mueschel/damp/classdamp.brd

## EAGLE design classdamp.brd (2013-05-06)

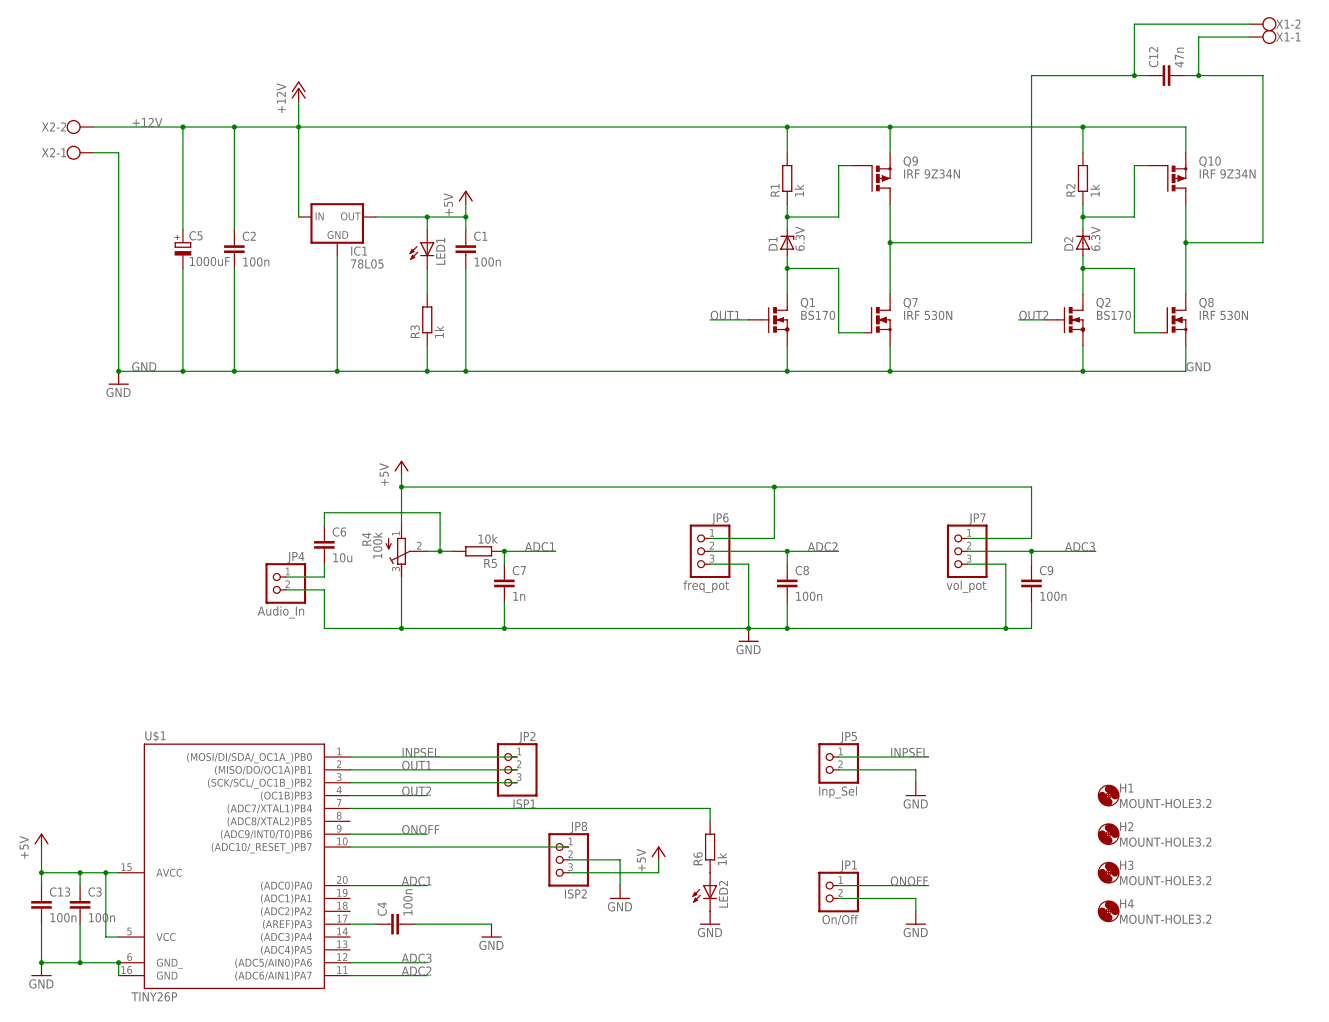
[picture p1: schematic classdamp.sch]

Parts:
C1, C2, C3, C4, C8, C9, C13: 100n; C0805K
C5: 1000uF; E5-8,5
C6: 10u; C0805K
C7: 1n; C0805K
C12: 47n; C5B3.5
D1, D2: 6.3V; ZDIO-5
H1, H2, H3, H4: MOUNT-HOLE3.2; 3,2
IC1: 78L05; 78LXX
JP1: On/Off; 1X02
JP2: ISP1; 1X03
JP4: Audio_In; 1X02
JP5: Inp_Sel; 1X02
JP6: freq_pot; 1X03
JP7: vol_pot; 1X03
JP8: ISP2; 1X03
LED1, LED2: LEDSML0805; SML0805
Q1, Q2: BS170; SOT54E
Q7, Q8: IRF 530N; TO220BV
Q9, Q10: IRF 9Z34N; TO220BV
R1, R2, R3, R6: 1k; R0805
R4: 100k; RTRIM64W
R5: 10k; R0805
U$1: TINY26P; DIL20
X1, X2: W237-102

Connections:
+5V: C1.1, C3.1, C13.1, IC1.OUT, JP6.1, JP7.1, JP8.3, LED1.A, R4.1 (E), U$1.5 (VCC), U$1.15 (AVCC)
+12V: C2.1, C5.+, IC1.IN, Q9.S, Q10.S, R1.2, R2.2, X2.2
ADC1: C7.1, R5.1, U$1.20 ((ADC0)PA0)
ADC2: C8.1, JP6.2, U$1.11 ((ADC6/AIN1)PA7)
ADC3: C9.1, JP7.2, U$1.12 ((ADC5/AIN0)PA6)
GND: C1.2, C2.2, C3.2, C4.2, C5.-, C7.2, C8.2, C9.2, C13.2, IC1.GND, JP1.2, JP4.2, JP5.2, JP6.3, JP7.3, JP8.2, LED2.C, Q1.S, Q2.S, Q7.S, Q8.S, R3.1, R4.3 (A), U$1.6 (GND_), U$1.16 (GND), X2.1
INPSEL: JP2.1, JP5.1, U$1.1 ((MOSI/DI/SDA/_OC1A_)PB0)
unnamed: LED1.C, R3.2
unnamed: C4.1, U$1.17 ((AREF)PA3)
unnamed: LED2.A, R6.1
unnamed: D1.A, Q1.D, Q7.G
unnamed: D2.A, Q2.D, Q8.G
unnamed: D1.C, Q9.G, R1.1
unnamed: D2.C, Q10.G, R2.1
unnamed: C6.2, JP4.1
unnamed: JP2.3, U$1.3 ((SCK/SCL/_OC1B_)PB2)
unnamed: C6.1, R4.2 (S), R5.2
unnamed: C12.1, Q7.D, Q9.D, X1.2
unnamed: JP8.1, U$1.10 ((ADC10/_RESET_)PB7)
unnamed: C12.2, Q8.D, Q10.D, X1.1
unnamed: R6.2, U$1.7 ((ADC7/XTAL1)PB4)
ONOFF: JP1.1, U$1.9 ((ADC9/INT0/T0)PB6)
OUT1: JP2.2, Q1.G, U$1.2 ((MISO/DO/OC1A)PB1)
OUT2: Q2.G, U$1.4 ((OC1B)PB3)

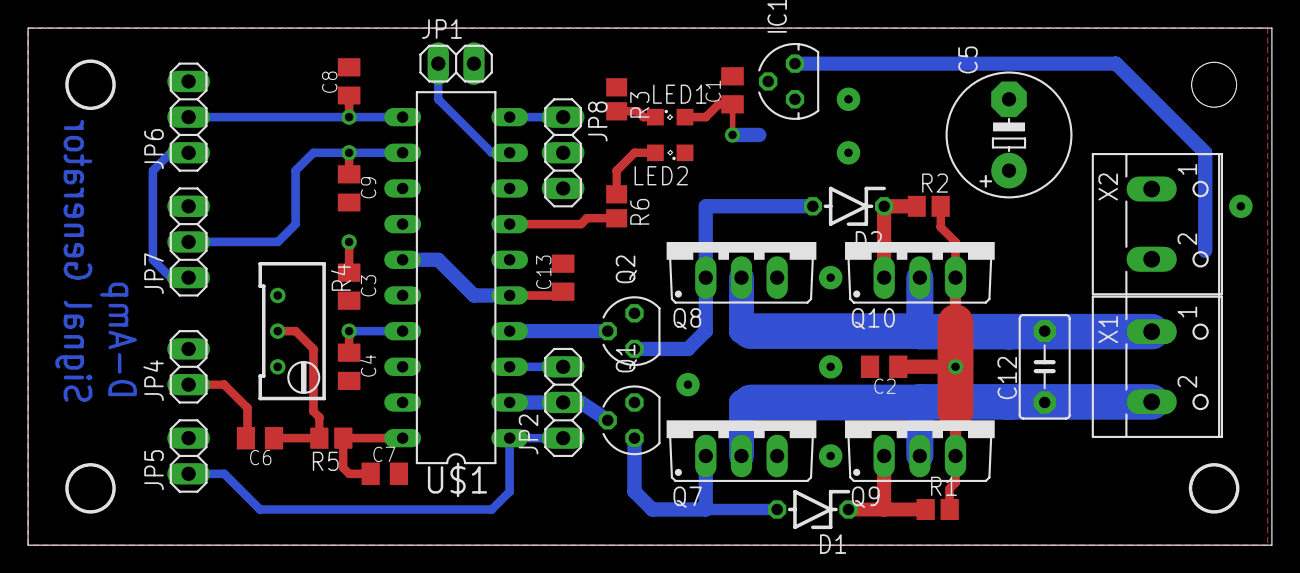
[picture p2: board classdamp.brd from above]

Board: 2 copper layers, 88.6 x 36.8 mm, 42 parts (1 on the bottom side), 24 nets.
