mueschel/damp/damp_orig.brd

## EAGLE design damp_orig.brd (2013-04-27)

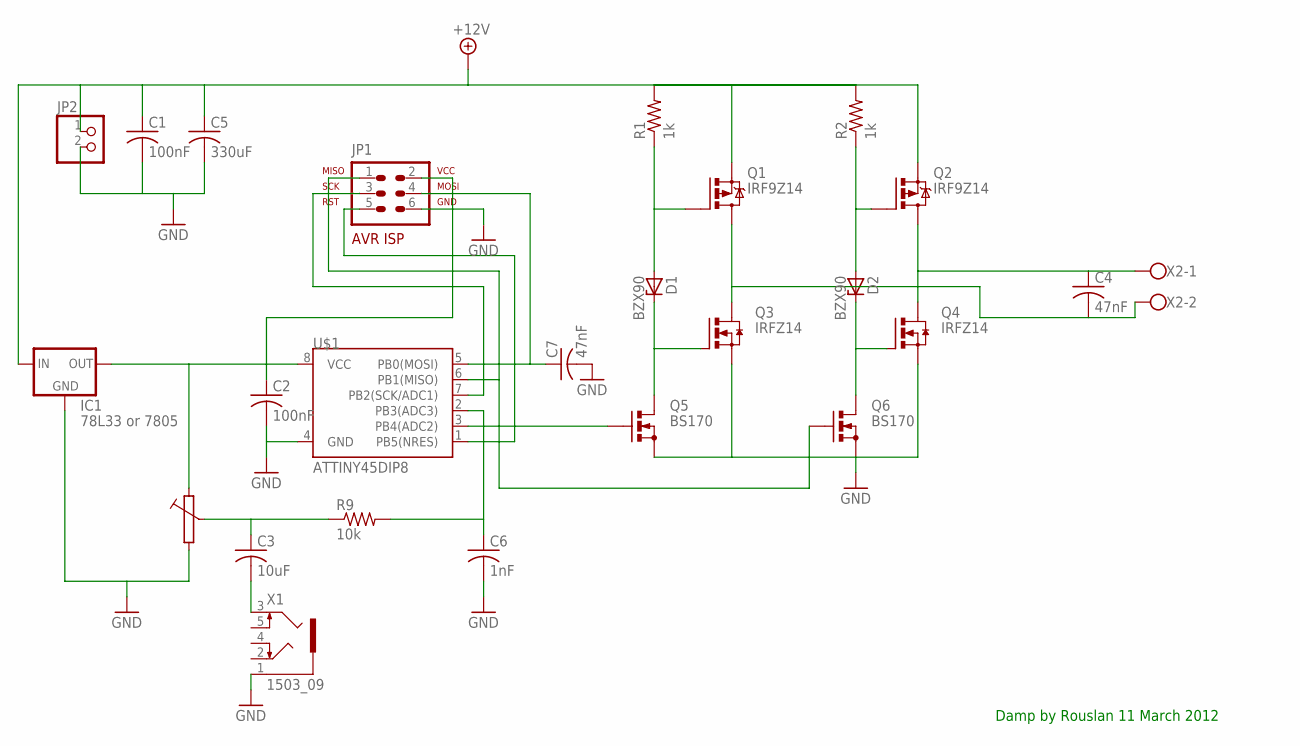
[picture p3: schematic damp_orig.sch]

Parts:
C1, C2: 100nF; C025-025X050
C3: 10uF; C025-025X050
C4, C7: 47nF; C025-025X050
C5: 330uF; C025-025X050
C6: 1nF; C025-025X050
D1, D2: BZX90; DO34Z7
IC1: 78L33 or 7805; TO-92
JP1: AVR-ISP-6VERT; AVR-ISP-6
JP2: PINHD-1X2; 1X02
Q1, Q2: IRF9Z14; TO220BV
Q3, Q4: IRFZ14; TO262-V
Q5, Q6: BS170; SOT54E
R1, R2: 1k; 0204/7
R9: 10k; 0309/10
U$1: ATTINY45DIP8; DIP08
X1: 1503_09
X2: W237-102

Connections:
+12V: C1.1, C5.1, IC1.2 (IN), JP2.1, Q1.S, Q2.S, R1.2, R2.2
GND: C1.2, C2.2, C5.2, C6.2, C7.2, IC1.1 (GND), JP1.6, JP2.2, Q3.3 (S), Q4.3 (S), Q5.S, Q6.S, U$1.4 (GND), X1.1
unnamed: D1.A, Q1.G, R1.1
unnamed: D2.A, Q2.G, R2.1
unnamed: C4.2, Q1.D, Q3.2 (D), X2.2
unnamed: JP1.5, U$1.1 (PB5(NRES))
unnamed: C4.1, Q2.D, Q4.2 (D), X2.1
unnamed: D1.C, Q3.1 (G), Q5.D
unnamed: D2.C, Q4.1 (G), Q6.D
unnamed: C6.1, R9.2, U$1.2 (PB3(ADC3))
unnamed: JP1.4, U$1.5 (PB0(MOSI))
unnamed: C2.1, IC1.3 (OUT), JP1.2, U$1.8 (VCC)
unnamed: JP1.1, Q6.G, U$1.6 (PB1(MISO))
unnamed: JP1.3, U$1.7 (PB2(SCK/ADC1))
unnamed: C3.1, R9.1
unnamed: Q5.G, U$1.3 (PB4(ADC2))
unnamed: C3.2, X1.3

Notes on the sheet:
Damp by Rouslan 11 March 2012

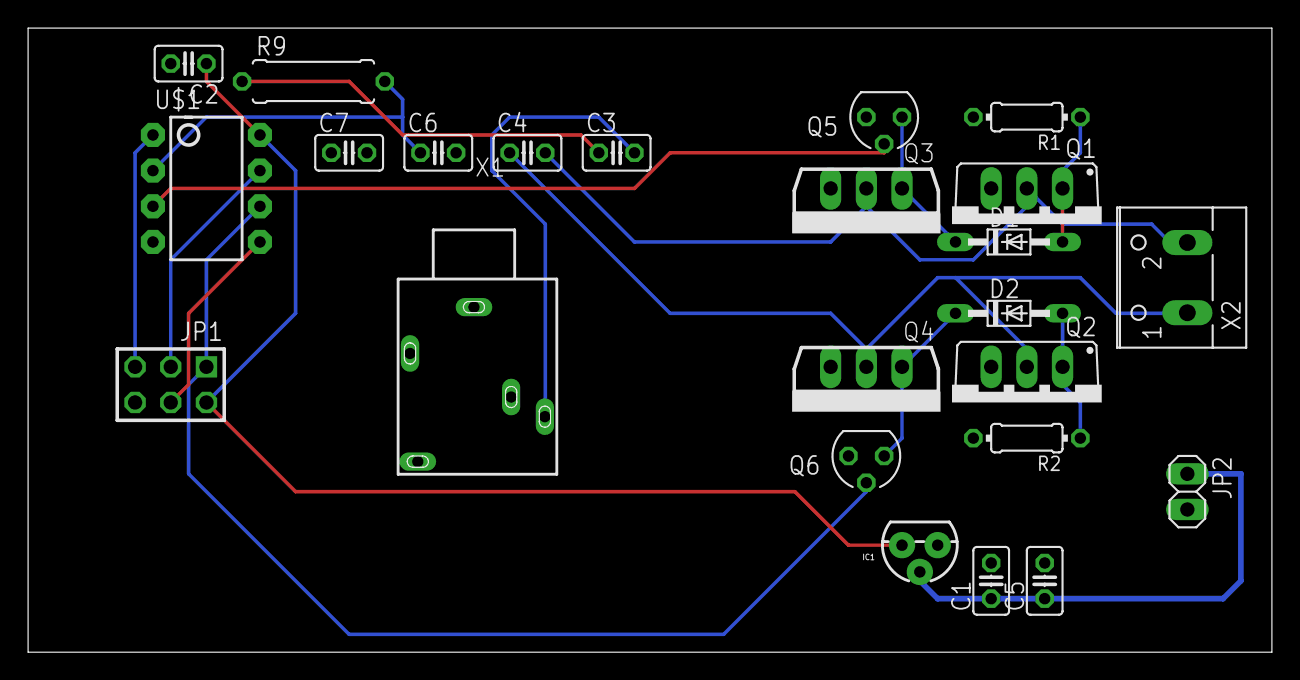
[picture p4: board damp_orig.brd from above]

Board: 2 copper layers, 88.6 x 44.4 mm, 24 parts (0 on the bottom side), 17 nets.
