mueschel/damp/(commit log)

2013-04-27 Warenkorb hinzugefügt.
    [Warenkorb.csv]
2013-04-27 added original schematics & tested layout
    [damp_orig.brd, damp_orig.sch]
2013-04-27 added new schematics
    [classdamp.brd, classdamp.sch]
2013-04-27 size 37x89 -> 5 pieces on 200x90 PCB
    [classdamp.brd]
2013-04-27 Changed text size, DRU passed.
    [classdamp.brd]
2013-04-28 Just few small things...
    [classdamp.brd, classdamp.sch]
2013-04-28 Bemaßung
    [classdamp.brd]
2013-04-28 R/C durch SMD ersetzt - bessere GND-Flächen
    [classdamp.brd, classdamp.sch]
2013-04-28 few details
    [classdamp.brd, classdamp.sch]
2013-04-29 added partlist
    [classdamp.brd, classdamp.sch]
2013-04-29 updated reichelt order
    [Warenkorb.csv, classdamp.brd, classdamp.sch]
2013-04-29 few changes
    [classdamp.brd]
2013-04-29 kind of a change
    [classdamp.brd]
2013-05-05 Nothing important
    [classdamp.brd]
2013-05-05 removed top layer for production
    [classdamp.brd]
2013-05-05 adjusted width
    [classdamp.brd]
2013-05-05 wrong layer...
    [classdamp.brd]
2013-05-06 changed to dual-layer design
    [classdamp.brd, classdamp.sch]
2013-05-20 added audio function. switch via on/off
